AlbertoVelascoUCLM/TFG/(list of files, cad)

Other CAD files:
OtrosRecursos/AnillosTurbina.dwg
OtrosRecursos/MesaEnsayo.dwg
OtrosRecursos/CircuitosCombustible.dwg
OtrosRecursos/Circuitos.dwg
OtrosRecursos/EsquemaElectrico.dwg
